HexabitzPlatform/H21R2x-Hardware/README.md

# H21R20-Hardware
Hexabitz ESP32-C3 WiFi+BLE Module Hardware Design
