HexabitzPlatform/H21R2x-Hardware/H21R2/Released/BOM/H21R2.xlsx

 |  | www.hexabitz.com info@hexabitz.com |  | Bill Of Materials
Customer | Hexabitz | Revision | 0
Project | Hexabitz Modules | Date | 2022-09-07
Board | ESP32-C3 Wifi+BLE (H21R20) | Notes
Designator | Description | Manufacturer Part Number | Manufacturer | Octopart Url | Quantity
JP1 | Headers & Wire Housings Unshrouded 1 POS T/H | 5-146280-1 | TE Connectivity | https://octopart.com/5-146280-1-te+connectivity+%2F+amp-40259676?r=sp | 1
JP2 | Conn Unshrouded Header HDR 3 POS 2.54mm Solder ST Top Entry Thru-Hole Carton | 5-146281-3 | TE Connectivity | https://octopart.com/5-146281-3-te+connectivity+%2F+amp-39745942?r=sp | 1
R3 , R8 , R9 , R11 ,R12 ,R13 | RES SMD 0 OHM JUMPER 1/16W 0402 | AC0402JR-070RL | YAGEO | https://octopart.com/ac0402jr-070rl-yageo-21711084?r=sp | 6
R16 , R17 | Thick Film Resistors - SMD 0603 27ohms 5% AEC-Q200 | ERJ-3GEYJ270V | Panasonic | https://octopart.com/erj-3geyj270v-panasonic-55422052?r=sp | 2
R1 , R4 | Thick Film Resistors - SMD 0603 270 Ohm 5% Tol | ERJ-3GEYJ271V | Panasonic | https://octopart.com/erj-3geyj271v-panasonic-55560546?r=sp | 2
R2 , R5 , R7 , R10 , R14 | RES 10K Ohm 5% 0603 | CRCW060310K0JNEB | Vishay | https://octopart.com/crcw060310k0jneb-vishay-46603269 | 5
C10 , C11 | Multilayer Ceramic Capacitor, 47 pF, 50 V, ± 5%, C0G (NP0), 0603 [1608 Metric] | CL10C470JB8NNNC | Samsung | https://octopart.com/cl10c470jb8nnnc-samsung-9299382?r=sp | 2
C1,C2, C5 , C7 , C4, C12 | CAP CER 0.1 UF 10% X7R 0603 | C0603C104K8RACTU | KEMET | https://octopart.com/c0603c104k8ractu-kemet-145075?r=sp&s=9bS9ASSwSEqMCE9KBEQZ0g | 6
C6 | CAP CER 1 UF 16V X7R 0805 | CC0805KKX7R7BB105 | YAGEO | https://octopart.com/cc0805kkx7r7bb105-yageo-8376555?r=sp | 1
C8, C3 | CAP TANT 4.7 UF 10V 20% 0805 | 10TPU4R7MSI | Panasonic | https://octopart.com/10tpu4r7msi-panasonic-29487748?r=sp | 2
C13 | Tantalum Capacitors - Solid SMD 16V 10uF 10% 1210 ESR= 500 mOhm | TPSB106K016R0500 | KYOCERA AVX | https://octopart.com/tpsb106k016r0500-kyocera+avx-71041120?r=sp | 1
FB1 | Ind chip Bead Multi-Layer 30 ohms 25% 100MHZ Ferrite 1,5A 0603Punched paper T/R | MMZ1608Y300BTA00 | TDK | https://octopart.com/mmz1608y300bta00-tdk-7906990?r=sp | 1
D1 , D10 | Red 0603 130° Clear 54 mcd 2 V Surface Mount ChipLED | VLMS1300-GS08 | Vishay | https://octopart.com/vlms1300-gs08-vishay-21709201?r=sp&s=0nXJNjGsSbWwqfqWlZv0EA | 2
D2 , D3 , D4 , D5 , D6 , D7 , D8 , D9 | TVS DIODE 3,3V 10,9V SOD323 | CDSOD323-T03SC | BOURNS INC | https://octopart.com/cdsod323-t03sc-bourns-10487153?r=sp | 8
U1 | MCU 32-Bit ARM Cortex-M0+ RISC 512kByte Flash 1.7V to 3.6V 48-Pin UFQFPN Tray | STM32G0B1CEU6N | STMicroelectronics | https://octopart.com/stm32g0b1ceu6n-stmicroelectronics-116364672?r=sp | 1
IC1 | Multiprotocol Modules SMD module, ESP32-C3FN4, PCB antenna, -40 C +85 C | ESP32-C3-MINI-1-N4 | Espressif Systems | https://octopart.com/esp32-c3-mini-1-n4-espressif+systems-116589975?r=sp | 1
X1 | 8,0000MHZ 33pF SMD MURATA Resonators | CSTNE8M00G550000R0 | Murata | https://octopart.com/cstne8m00g550000r0-murata-91406934?r=sp | 1
