HexabitzPlatform/H21R2x-Hardware/H21R2/Documentation/H21R2 Schematics.pdf

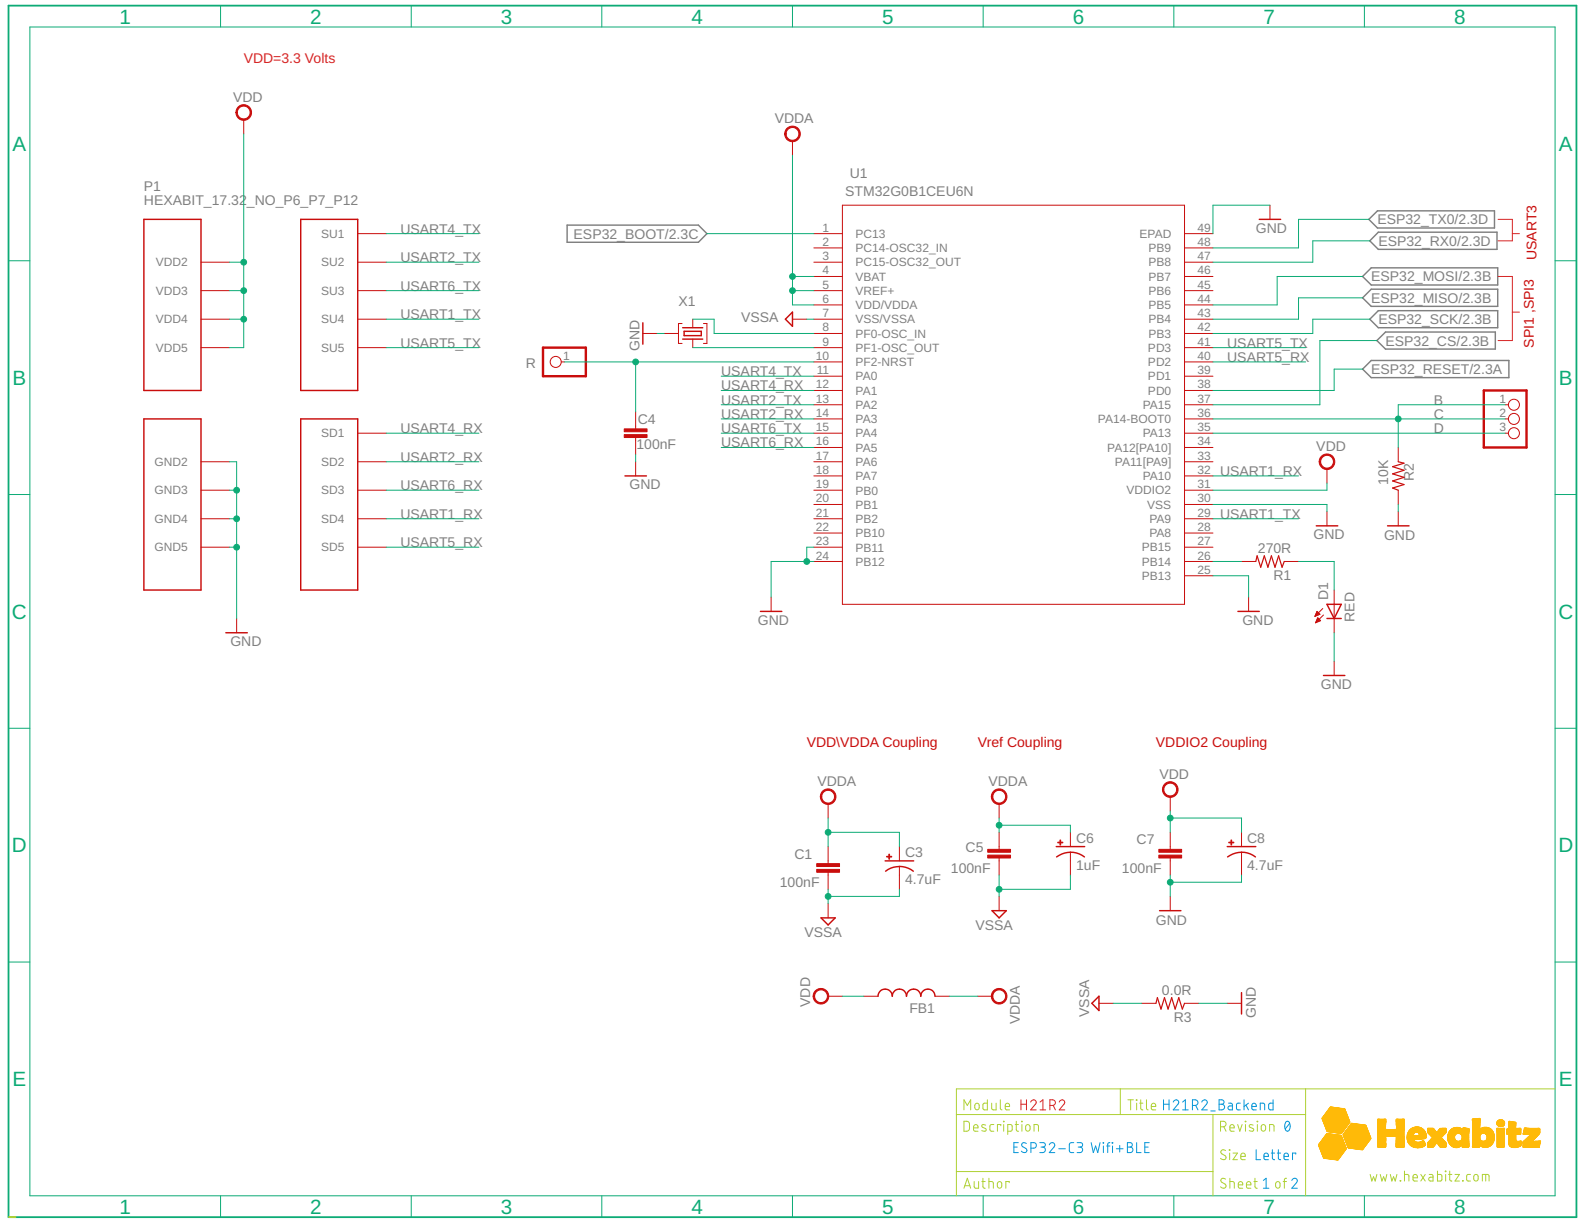
[picture p1: page 1]

5 | 45 PB7
6 | 44 PB6

35 PA14-BOOT0 | D

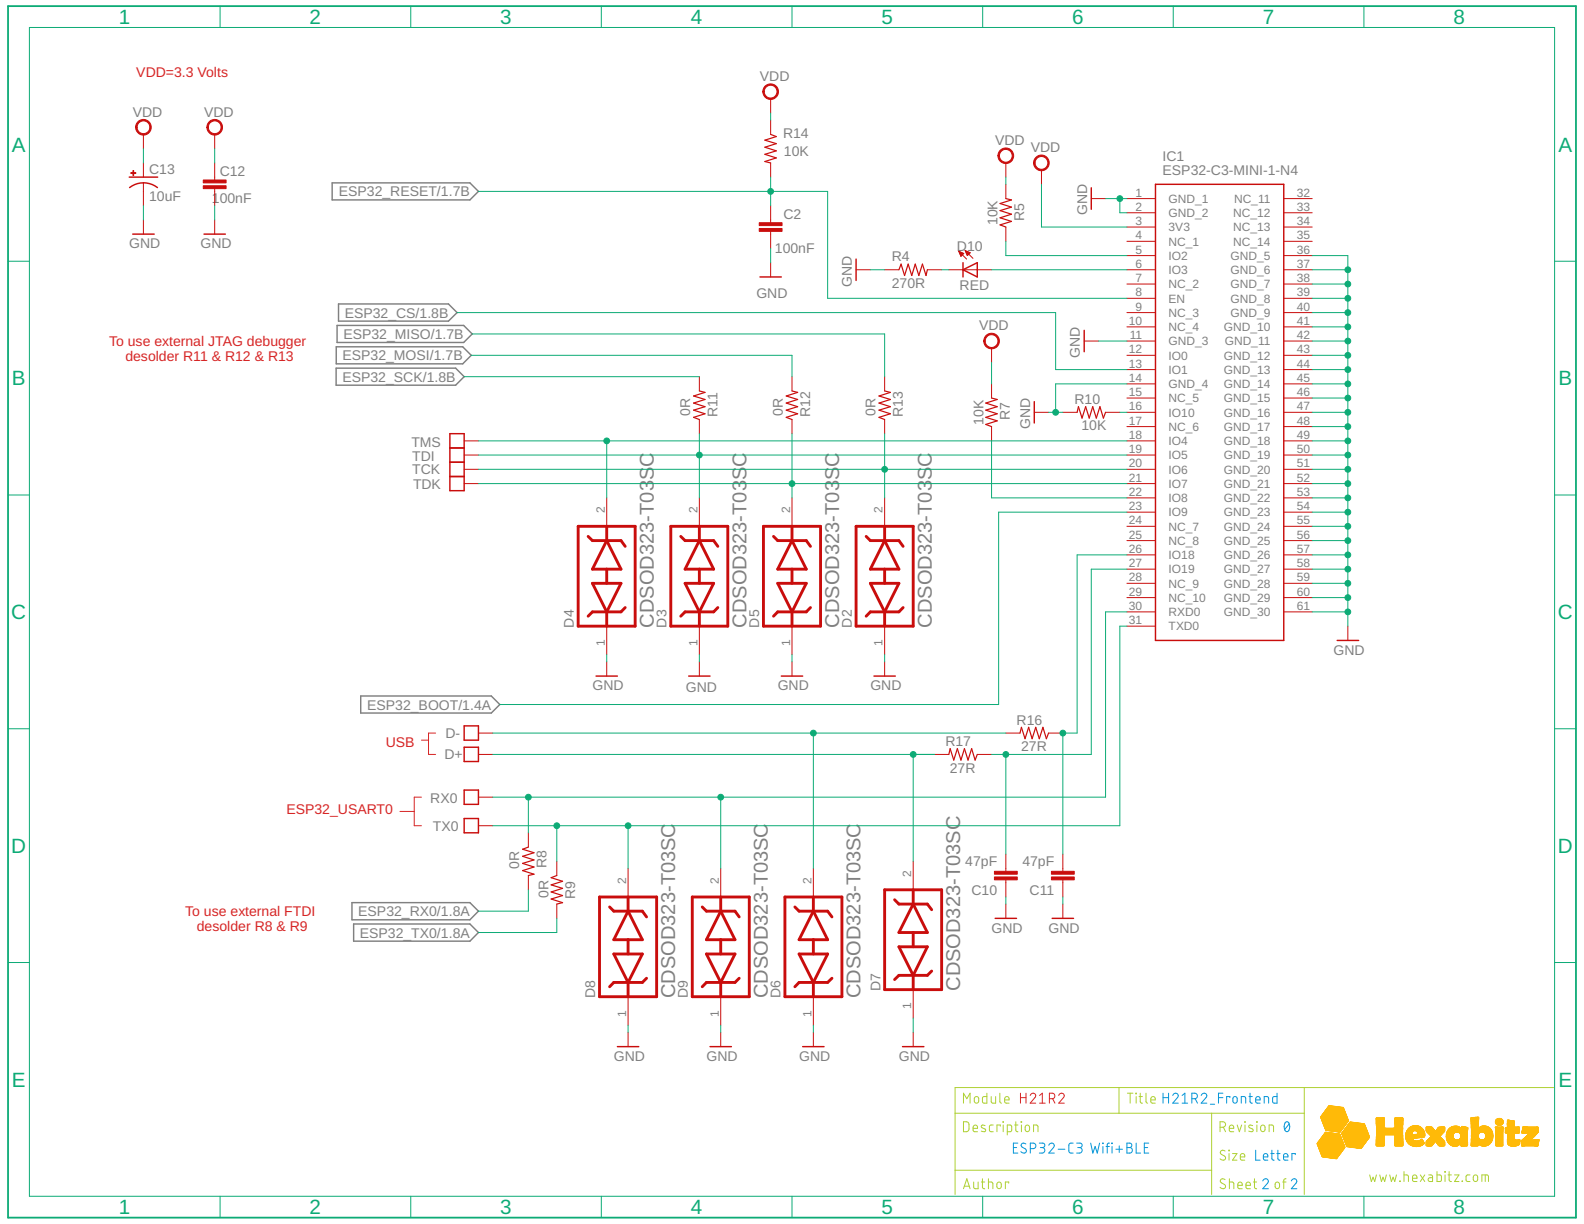
[picture p2: page 2]
