HexabitzPlatform/H21R2x-Hardware/H21R2/Design/H21R2.brd

## EAGLE design H21R2/Design/H21R2.brd (2023-11-26)

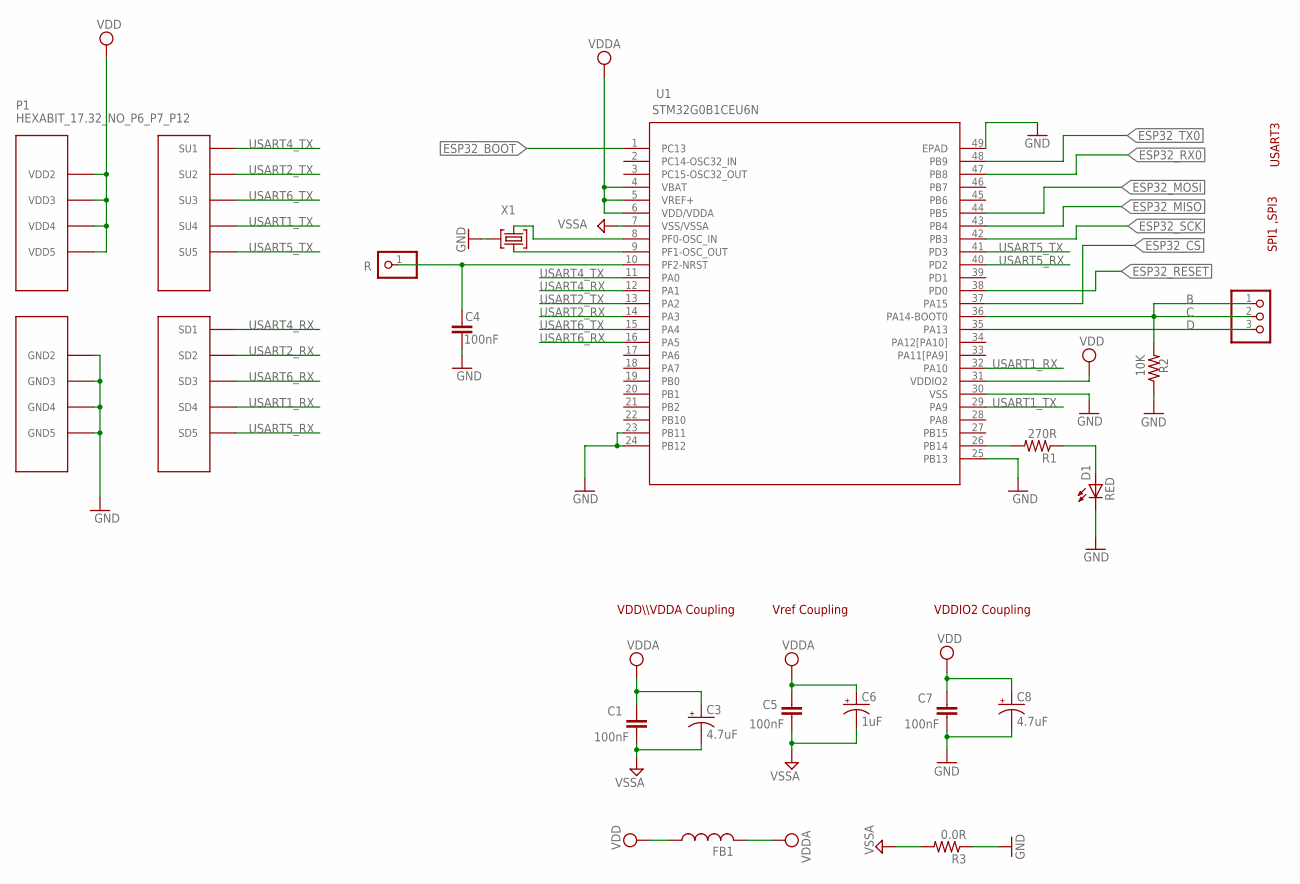
[picture p3: schematic H21R2.sch, sheet 1]

Parts:
C1, C5, C7: 100nF; C-0603; TOLERANCE 10%; VOLTAGE_RATING 16.0 V; MPN '0603YC104K4T2A
C3: 4.7uF; C-0805-POL; TOLERANCE 20%; VOLTAGE_RATING 10.0 V; MPN '10TPU4R7MSI
C4: 100nF; C-0603; TOLERANCE 10%; VOLTAGE_RATING 16.0 V; MPN 0603YC104K4T2A
C6: 1uF; C-0805-POL; TOLERANCE 20%; VOLTAGE_RATING 10.0 V; MPN 'CC0805KKX7R7BB105
C8: 4.7uF; C-0805-POL; TOLERANCE 10%; VOLTAGE_RATING 16.0 V; MPN '10TPU4R7MSI
D1: RED; VLMS1300-GS08
FB1: FB-TDK_MMZ1608Y300B; MPN MMZ1608Y300BTA00
JP1: PINHD-1X3; 1X03
P1: HEXABIT_17.32_NO_P6_P7_P12
R: PINHD-1X1; 1X01
R1: 270R; R-0603; MPN 'ERJ-3GEYJ271V
R2: 10K; R-0603; MPN '060300J0103T5E
R3: 0.0R; R-0603; MPN RC0603JR-070RL
U1: STM32G0B1CEU6N; HEXABITZ_ICS_QFN_B1CEU6_STM-L
X1: 8MHZ; XTALL_CSTCE8M00G52; MPN CSTNE8M00G550000R0

Connections:
C: JP1.1, JP1.2, R2.2, U1.36 (PA14-BOOT0)
D: JP1.3, U1.35 (PA13)
ESP32_BOOT: U1.1 (PC13); also elsewhere on the board
ESP32_CS: U1.37 (PA15); also elsewhere on the board
ESP32_MISO: U1.43 (PB4); also elsewhere on the board
ESP32_MOSI: U1.44 (PB5); also elsewhere on the board
ESP32_RESET: U1.38 (PD0); also elsewhere on the board
ESP32_RX0: U1.47 (PB8); also elsewhere on the board
ESP32_SCK: U1.42 (PB3); also elsewhere on the board
ESP32_TX0: U1.48 (PB9); also elsewhere on the board
GND: C4.1, C7.1, C8.2 (-), D1.C, P1.PAD_PD8 (GND2), P1.PAD_PD9 (GND3), P1.PAD_PD10 (GND4), P1.PAD_PD11 (GND5), R2.1, R3.1, U1.23 (PB11), U1.24 (PB12), U1.25 (PB13), U1.30 (VSS), U1.49 (EPAD), X1.P$2 (2); also elsewhere on the board
unnamed: U1.8 (PF0-OSC_IN), X1.P$1 (1)
unnamed: U1.9 (PF1-OSC_OUT), X1.P$3 (3)
unnamed: C4.2, R.1, U1.10 (PF2-NRST)
unnamed: R1.2, U1.26 (PB14)
unnamed: D1.A, R1.1
USART1_RX: P1.PAD_PD4 (SD4), U1.32 (PA10)
USART1_TX: P1.PAD_PU4 (SU4), U1.29 (PA9)
USART2_RX: P1.PAD_PD2 (SD2), U1.14 (PA3)
USART2_TX: P1.PAD_PU2 (SU2), U1.13 (PA2)
USART4_RX: P1.PAD_PD1 (SD1), U1.12 (PA1)
USART4_TX: P1.PAD_PU1 (SU1), U1.11 (PA0)
USART5_RX: P1.PAD_PD5 (SD5), U1.40 (PD2)
USART5_TX: P1.PAD_PU5 (SU5), U1.41 (PD3)
USART6_RX: P1.PAD_PD3 (SD3), U1.16 (PA5)
USART6_TX: P1.PAD_PU3 (SU3), U1.15 (PA4)
VDD: C7.2, C8.1 (+), FB1.1, P1.PAD_PU8 (VDD2), P1.PAD_PU9 (VDD3), P1.PAD_PU10 (VDD4), P1.PAD_PU11 (VDD5), U1.31 (VDDIO2); also elsewhere on the board
VDDA: C1.2, C3.1 (+), C5.2, C6.1 (+), FB1.2, U1.4 (VBAT), U1.5 (VREF+), U1.6 (VDD/VDDA)
VSSA: C1.1, C3.2 (-), C5.1, C6.2 (-), R3.2, U1.7 (VSS/VSSA)

Notes on the sheet:
VDDIO2 Coupling
VDD\\\VDDA Coupling
Vref Coupling
SPI1 ,SPI3
USART3

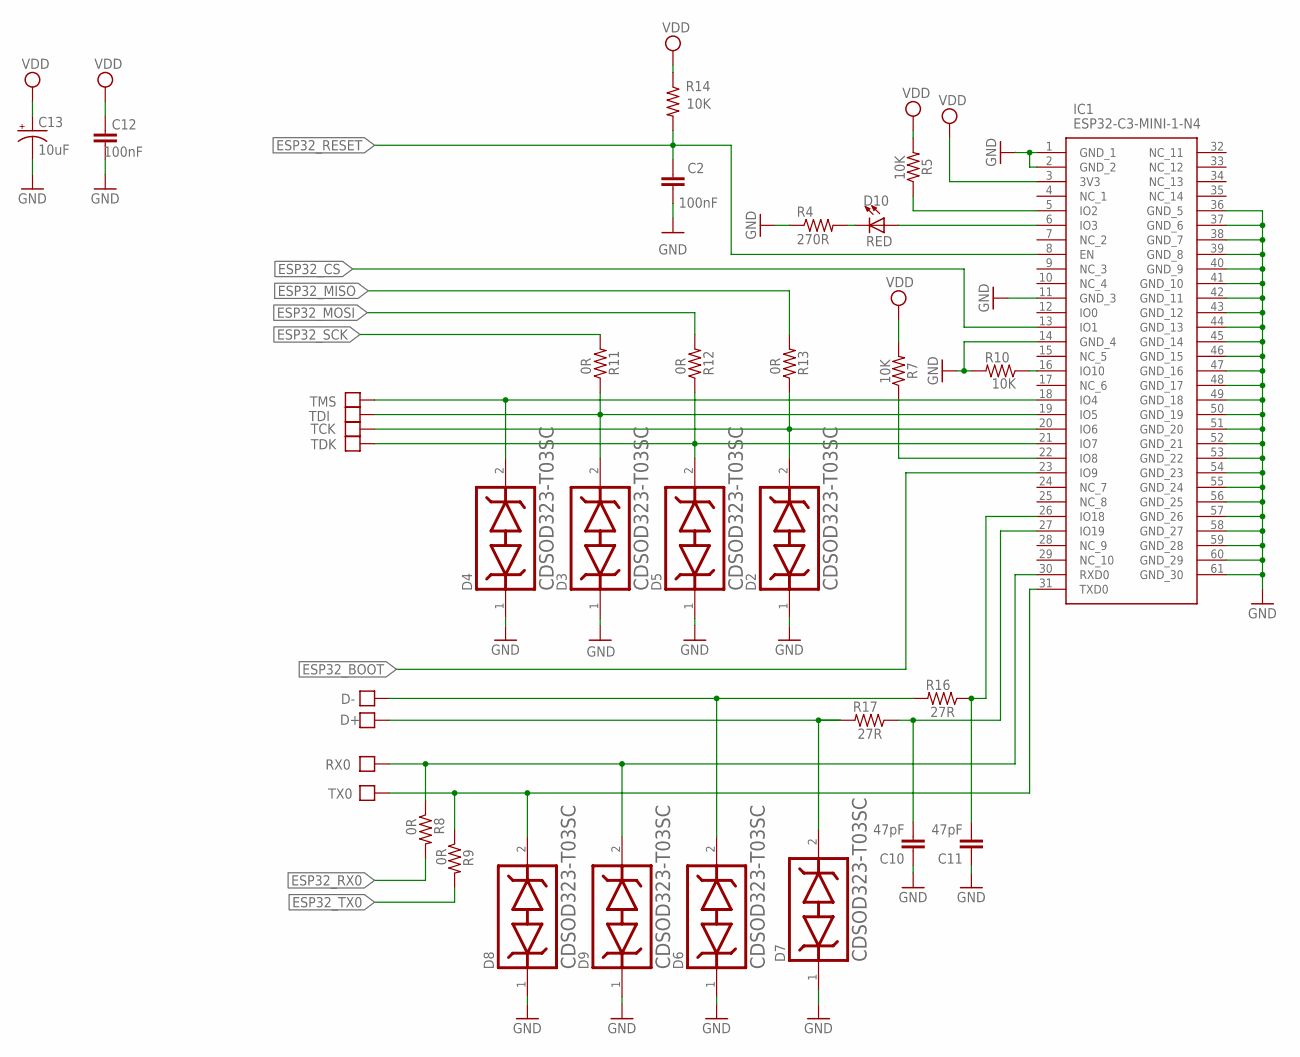
[picture p4: schematic H21R2.sch, sheet 2]

Parts:
C2, C12: 100nF; C-0603; TOLERANCE 10%; VOLTAGE_RATING 16.0 V; MPN '0603YC104K4T2A
C10, C11: 47pF; C-0603; TOLERANCE 10%; VOLTAGE_RATING 16.0 V; MPN '0603YC104K4T2A
C13: 10uF; C-1210-POL
D2, D3, D4, D5, D6, D7, D8, D9: BOURNS_CDSOD323-T03SCBOURNS_CDSOD323-T03SC_0_0; BOURNS_CDSOD323-T03SC_0
D10: RED; VLMS1300-GS08
D+: PAD4
D-: PAD4
IC1: ESP32-C3-MINI-1-N4; ESP32C3MINI1N4
R4: 270R; R-0603; MPN 'ERJ-3GEYJ271V
R5, R7, R10, R14: 10K; R-0603; MPN RC0603JR-070RL
R8, R9: 0R; R-0603; MPN RC0603JR-070RL
R11, R12, R13: 0R; R-0402; MPN RC0603JR-070RL
R16, R17: 27R; R-0603; MPN RC0603JR-070RL
RX0: PAD4
TCK: PAD4
TDI: PAD4
TDK: PAD4
TMS: PAD4
TX0: PAD4

Connections:
DATA_N: C11.2, IC1.26 (IO18), R16.1
DATA_P: C10.2, IC1.27 (IO19), R17.1
D_N: D6.2, D-.P$1, R16.2
D_P: D7.2, D+.P$1, R17.2
ESP32_BOOT: IC1.23 (IO9); also elsewhere on the board
ESP32_CS: IC1.13 (IO1); also elsewhere on the board
ESP32_MISO: R13.2; also elsewhere on the board
ESP32_MOSI: R12.2; also elsewhere on the board
ESP32_RESET: C2.2, IC1.8 (EN), R14.2; also elsewhere on the board
ESP32_RX0: R8.2; also elsewhere on the board
ESP32_SCK: R11.2; also elsewhere on the board
ESP32_TX0: R9.2; also elsewhere on the board
GND: C2.1, C10.1, C11.1, C12.1, C13.2 (-), D2.1, D3.1, D4.1, D5.1, D6.1, D7.1, D8.1, D9.1, IC1.1 (GND_1), IC1.2 (GND_2), IC1.11 (GND_3), IC1.14 (GND_4), IC1.36 (GND_5), IC1.37 (GND_6), IC1.38 (GND_7), IC1.39 (GND_8), IC1.40 (GND_9), IC1.41 (GND_10), IC1.42 (GND_11), IC1.43 (GND_12), IC1.44 (GND_13), IC1.45 (GND_14), IC1.46 (GND_15), IC1.47 (GND_16), IC1.48 (GND_17), IC1.49 (GND_18), IC1.50 (GND_19), IC1.51 (GND_20), IC1.52 (GND_21), IC1.53 (GND_22), IC1.54 (GND_23), IC1.55 (GND_24), IC1.56 (GND_25), IC1.57 (GND_26), IC1.58 (GND_27), IC1.59 (GND_28), IC1.60 (GND_29), IC1.61 (GND_30), R4.1, R10.2; also elsewhere on the board
unnamed: D4.2, IC1.18 (IO4), TMS.P$1
unnamed: IC1.22 (IO8), R7.1
unnamed: D10.C, R4.2
unnamed: D9.2, IC1.30 (RXD0), R8.1, RX0.P$1
unnamed: D8.2, IC1.31 (TXD0), R9.1, TX0.P$1
unnamed: IC1.16 (IO10), R10.1
unnamed: D2.2, IC1.20 (IO6), R13.1, TCK.P$1
unnamed: D5.2, IC1.21 (IO7), R12.1, TDK.P$1
unnamed: D10.A, IC1.6 (IO3)
unnamed: IC1.5 (IO2), R5.1
unnamed: D3.2, IC1.19 (IO5), R11.1, TDI.P$1
VDD: C12.2, C13.1 (+), IC1.3 (3V3), R5.2, R7.2, R14.1; also elsewhere on the board

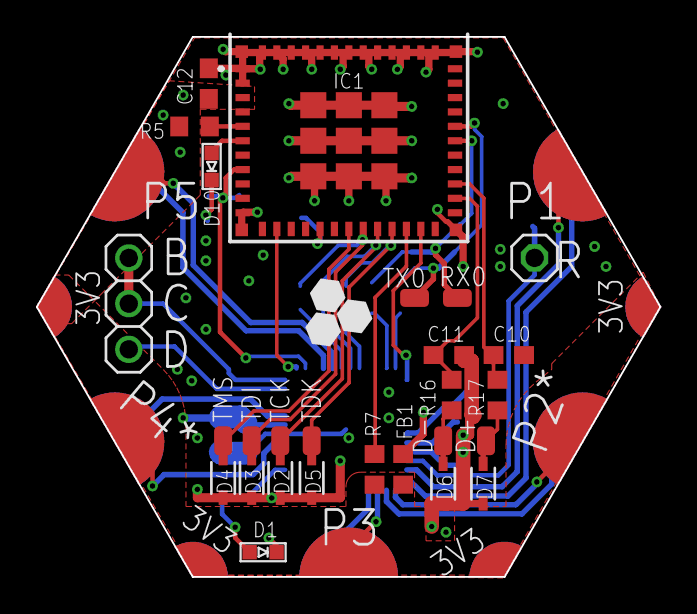
[picture p5: board H21R2.brd from above]

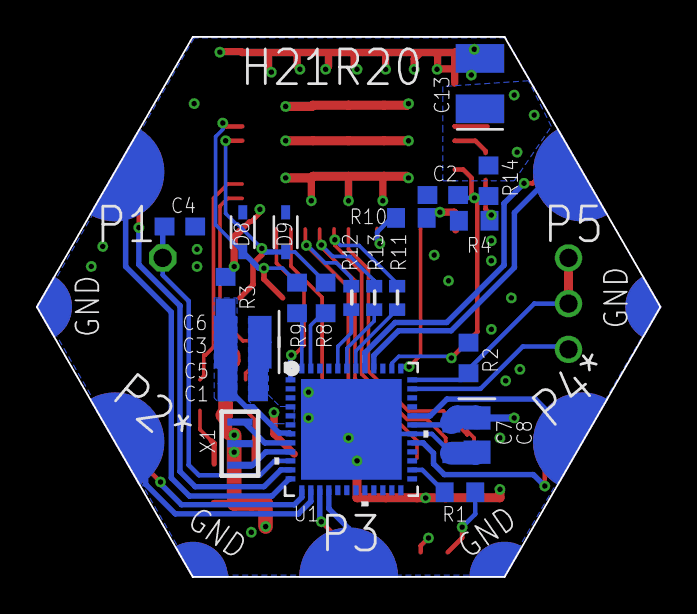
[picture p6: board H21R2.brd from below]

Board: 2 copper layers, 34.6 x 30.0 mm, 52 parts (24 on the bottom side), 44 nets.
