HexabitzPlatform/H21R2x-Hardware/(commit log)

2021-06-23 - schematic and PCB designes - BOM - output files - Documentation
    [H21R20.brd, H21R20.sch, H21R20.xlsx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]
2022-09-12 -Changing the MC to STM32G0B1CEU6N -Changing the design of the hardware of the ESP32 circuit and the way it is connected to the MC,and adding test points to help with programming and debugging
    [H21R20.brd, H21R20.sch, H21R20.xlsx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]
2022-09-21 -Changing some issues in the design to improve the performance
    [H21R20.brd, H21R20.sch, H21R20.xlsx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]
2022-10-30 -Changing the placement of the ESP32
    [H21R20.brd, H21R20.sch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]
2023-02-13 -Correcting some documentaion issues
    [H21R20.brd, H21R20.sch, H21R20.xlsx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]
2023-11-16 -Improve the layout design -Change the jumber resistors footprint to 0402
    [H21R20.brd, H21R20.sch, H21R20.xlsx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]
2023-11-16 -Correct some documentation issues
    [H21R20.brd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]
2023-11-26 -Doing some changes at the silkscreen layer level
    [H21R20.brd, H21R20.sch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]
